MBot3D/MBot_3D_Printer_Board/GRID2+/INTERFACE.xls

BOM清单
产品型号：WHB-SYA
NO. | 名称 | 封装方式 | 规格 | 单位 | 数量 | 位号 | 品牌 | 备注
1 | 贴片电阻 | 0805 | 10K±1% | PCS | 7 | R3,R4,R5,R6,R7,R8,R9
2 | 贴片电容 | 0805 | 0.1UF±1% | PCS | 7 | C2,C3,C4,C5,C6,C7,C8
3 | IC | SOP-14 | 74AHC125D | PCS | 1 | IC1 | NXP
4 | SD卡槽 |  | SD二合一卡座 自弹式 11PIN | PCS | 1 | Q2 |  | 二合一卡座 自弹式
5 | 单排母 |  | 塑高6MM 1*20PIN |  | 1 | JP1 |  | 间距2.54MM 针数20 塑高6MM
6 |  |  | 塑高6MM 1*2PIN |  | 1 | JP3,JP4 |  | 间距2.54MM 针数2 塑高6MM
7 | 旋转编码器 |  | 旋转编码器（扁轴） 短柄 5脚 |  | 1 | S2 |  | 短柄15MM 带开关 定位数20位 额定电压5V 操作寿命30000次
8 | 接插件 |  | DC3牛角座弯角 26PIN |  | 1 | SV2 |  | 间距2.54MM 针数26PIN 弯角
单排母，旋转编码器，SD卡槽焊在同一面
2014.3.17
