MBot3D/MBot_3D_Printer_Board/GRID2+/MBot.xls

BOM清单
产品型号：MBot Cube Ⅱ
NO. | 名称 | 封装方式 | 规格 | 单位 | 数量 | 位号 | 品牌 | 备注
1 | 贴片电阻 | 805 | 0Ω | PCS | 11 | R5, R6, R8, R9, R11, R12, R14, R15,R17, R18, R67
 |  |  | 22Ω |  | 2 | R66,R69
 |  |  | 499Ω |  | 1 | R96
 |  |  | 1K±1% |  | 15 | R1, R68, R71, R72, R73, R74, R75, R76,R79,R81，R91, R103, R104, R105, R106, R107
 |  |  | 2.21K±1% |  | 10 | R4,R80,R87, R88, R97, R98, R99, R100, R101, R102
 |  |  | 4.7K±1% |  | 18 | R30,R39,R40,R41,R42,R43,R48,R53,R77,R78,R82, R83, R84, R85, R89,R90, R108, R109
 |  |  | 7.5K±1% |  | 5 | R34, R35, R36, R37, R38
 |  |  | 10K±1% |  | 13 | R7,R10,R13,R16,R19,R63,R64,R70,R86,R92,R93,R94,R95
 |  |  | 100K |  | 4 | R65,R110，R111，R112
 |  |  | 1M±1% |  | 3 | R113，R114，R115
2 | 贴片电容 | 805 | 22pF±5% | PCS | 5 | C15,C25,C26,C28,C29
 |  |  | 1uF±10% |  | 1 | C17
 |  |  | 10uF |  | 2 | C8,C9,
 |  |  | 100nF |  | 17 | C3,C4,C5,C6,C7,C16,C18,C19,C20,C21,C22,C23,C24,C27,C30, C32,C33
 |  | E型 | 47UF 35V 钽电容 |  | 5 | C10, C11, C12, C13, C14
3 | 直插电解电容 | E3,5-8 | 100uF/50V | PCS | 3 | C31,C34,C35
4 | IC |  | AQV252G 136 贴片 | PCS | 2 | U6,U7 | Panasonic
 |  |  | ATMEGA8U2-MU | PCS | 1 | U3 | Atmel
 |  |  | ATMEGA2560-16AU | PCS | 1 | U4 | Atmel
 |  | 805 | BLM21 磁珠 221 220R | PCS | 1 | L1 | TE
 |  | MSOP8 | NC7WZ02K8X | PCS | 1 | U5 | FAIRCHILD
 |  | SOP | PCA9533(PCA9533D)01,112 | PCS | 1 | U15 | NXP
 |  | 603 | PGB1010604 ESD静电保护PGB1010603(PGB1010603) | PCS | 2 | VR1，VR2 | Littelfuse
 |  | SOT89 | FDV301N | PCS | 3 | U16,17,U18 | FAIRCHILD
 |  |  | XC7WH14DC125 | PCS | 1 | U19 | NXP
 |  |  | PSMN7R0-30YL | PCS | 7 | Q1,Q2,Q3,Q4,Q5,Q6,Q7 | NXP
 |  |  | MCP4018T-502E/LT | PCS | 5 | U8,U9,U10,U11,U12 | Microchip
5 | 直插晶振 |  | 16MHZ 30ppm | PCS | 2 | Y1,Y2 | ABRACON | 相对偏差不高于30PPM
7 | 贴片二极管 | 805 | GREEN LED | PCS | 16 | 3.3V,5V,12V,DEBUG1, DEBUG2,DEBUG3,DEBUG4, FET1,FET2,FET3,FET4, FET5, FET6,FET7,RX,TX |  | 翠绿
 |  | 805 | RED LED | PCS | 1 | OVERHEAT |  | 红光
8 | 插件 |  | 8P单排母 2.54mm |  | 10 | BOTSTEP-A, BOTSTEP-B, BOTSTEP-X, BOTSTEP-Y, BOTSTEP-Z |  | 间距2.54MM 排母1*8PIN
 |  |  | CH3.96*4P |  | 5 | A-STEPPER, B-STEPPER, X-STEPPER, Y-STEPPER, Z-STEPPER |  | 间距3.96MM 针数4PIN
 |  |  | 70543-0003 4PIN 2.54MM |  | 7 | X-MAX,X-MIN,Y-MAX, Y-MIN,Z-MAX, Z-MIN,RGB-LED | MOLEX | 间距2.54MM 针数4PIN 黑色
 |  |  | 5569 20P弯角插座 |  | 1 | X3 |  | 间距4.2MM 针数20 弯针
 |  |  | 6P双排针2*3 (2mm的脚距) |  | 2 | ICSP1, ICSP2
 |  |  | USB-B型母座 D字型 |  | 1 | X2 |  | B型母座 D字型 直插
 |  |  | 接线端子 2P KF2EDGK 5.08MM 直针 （一套含插头插座） |  | 4 | TEPM1,TEMP2,CFAN1,CFAN2 |  | 间距5.08MM 针数2PIN 直针
 |  |  | 接线端子 4P KF2EDGK 5.08MM 直针 （一套含插头插座） |  | 2 | EX1,EX2 |  | 间距5.08MM 针数4PIN 直针
 |  |  | 轻触按钮开关6*6*5 4脚 B3F-1022 |  | 1 | S1 | Omron | 尺寸 6*6*5 4脚1.47N
 |  |  | DC蜂鸣器 压电式 14*7 6-24V |  | 1 | LS1 |  | 压电式 额定电压12V 型号HYD1407B
 |  |  | DC3-26P |  | 1 | INTERFACE |  | 间距2.54MM 针数26PIN
2014.3.17
