MBot3D/MBot_3D_Printer_Board/MINI/INTERFACE.xls

BOM清单
产品型号：WHB-SYA
NO. | 名称 | 封装方式 | 规格 | 单位 | 数量 | 位号 | 品牌 | 备注
1 | 贴片电阻 | 805 | 10K±1% | PCS | 7 | R3,R4,R5,R6,R7,R8,R9
2 | 贴片电容 | 805 | 0.1UF±1% | PCS | 7 | C2,C3,C4,C5,C6,C7,C8
3 | 直插电解电容 | E3,5-8 | 220uF/35V | PCS | 1 | C10
4 |  | E3,5-8 | 220uF/25V | PCS | 1 | C11
5 | IC | SOP-14 | 74AHC125D | PCS | 1 | IC1 | NXP
6 |  | TO263-5 | LM2596S-3.3V | PCS | 1 | Q1 | Texas Instruments
7 | SD卡座 |  | SD二合一卡座 自弹式 11PIN | PCS | 1 | Q2 | SD二合一卡座 自弹式
8 | 排座 |  | 塑高6MM 20PIN |  | 1 | JP1 | 间距2.54MM 针数20 塑高6MM
9 |  |  | 塑高6MM 2PIN |  | 1 | JP3,JP4 | 间距2.54MM 针数2 塑高6MM
10 | 贴片电感 | 12*12*7 | 12*12*7 33uH | PCS | 1 | L1 | 标字330 感量33UH | 标字330 感量33UH
11 | 肖特基二极管 | SMA | SS34 | PCS | 1 | D1 | Fairchild Semiconductor | IN5822 SS34 SMA
12 | 旋转编码器 |  | 旋转编码器（扁轴） 短柄 5脚 |  | 1 | S2 | 短柄15MM 带开关 定位数20位 额定电压5V 操作寿命30000次
13 | 接插件 |  | DC3-26P |  | 1 | SV1 | 间距2.54MM 针数26PIN
SD卡座，单排母和旋转编码器焊在同一面
2014.3.17
