MBot3D/MBot_3D_Printer_Board/GRID2+/INTERFACE.brd

## EAGLE design GRID2+/INTERFACE.brd (2015-03-09)

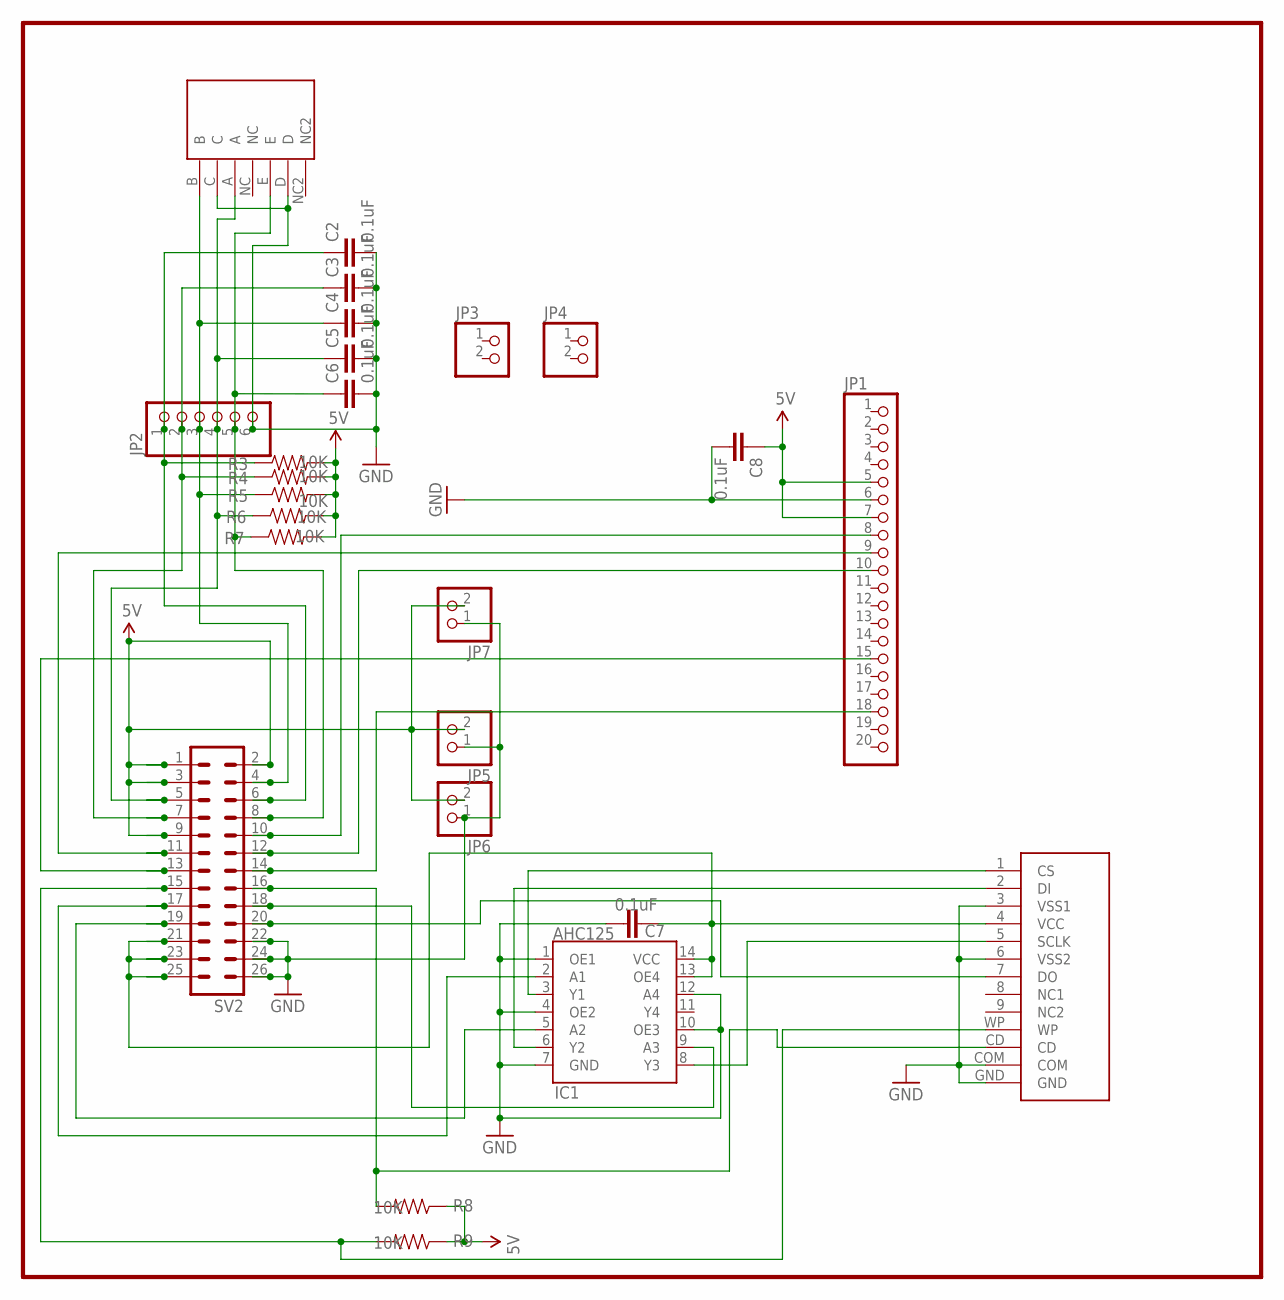
[picture p1: schematic INTERFACE.sch]

Parts:
C2, C3, C4, C5, C6, C7, C8: 0.1uF; 0805
IC1: AHC125; DIN14
JP1: PINHD-1X20; 1X20
JP2: PINHD-1X6; 1X06
JP3, JP4, JP5, JP6, JP7: PINHD-1X2; 1X02
Q2: SDCARD
R3, R4, R5, R6, R7, R8, R9: 10K; 0805
S2: DJFS; PIN5
SV2: ML26L

Connections:
5V: C8.1, JP1.5, JP1.7, JP5.2, JP6.2, JP7.2, R3.2, R4.2, R5.2, R6.2, R7.2, R8.1, R9.1, SV2.1, SV2.2, SV2.3, SV2.9
GND2: C2.2, C3.2, C4.2, C5.2, C6.2, C7.2, C8.2, IC1.1 (OE1), IC1.4 (OE2), IC1.7 (GND), IC1.10 (OE3), IC1.12 (A4), JP1.6, JP2.6, JP5.1, JP6.1, JP7.1, Q2.3 (VSS1), Q2.6 (VSS2), Q2.COM, Q2.GND, S2.C, S2.D, SV2.22, SV2.24, SV2.26
unnamed: IC1.3 (Y1), Q2.1 (CS)
unnamed: C2.1, JP2.1, R3.1, SV2.6
unnamed: IC1.2 (A1), SV2.17
unnamed: IC1.6 (Y2), Q2.2 (DI)
unnamed: Q2.CD, R8.2, SV2.16
unnamed: Q2.7 (DO), SV2.20
unnamed: JP1.15, SV2.13
unnamed: JP1.8, SV2.10
unnamed: JP1.10, SV2.12
unnamed: JP1.9, SV2.11
unnamed: JP1.18, SV2.14
unnamed: IC1.8 (Y3), Q2.5 (SCLK)
unnamed: C3.1, JP2.2, R4.1, SV2.7
unnamed: C4.1, JP2.3, R5.1, S2.B, SV2.4
unnamed: C5.1, JP2.4, R6.1, S2.A, SV2.5
unnamed: C6.1, JP2.5, R7.1, S2.E, SV2.8
unnamed: Q2.WP, R9.2, SV2.15
unnamed: IC1.5 (A2), SV2.19
unnamed: C7.1, IC1.13 (OE4), IC1.14 (VCC), Q2.4 (VCC), SV2.21, SV2.23, SV2.25
unnamed: IC1.9 (A3), SV2.18

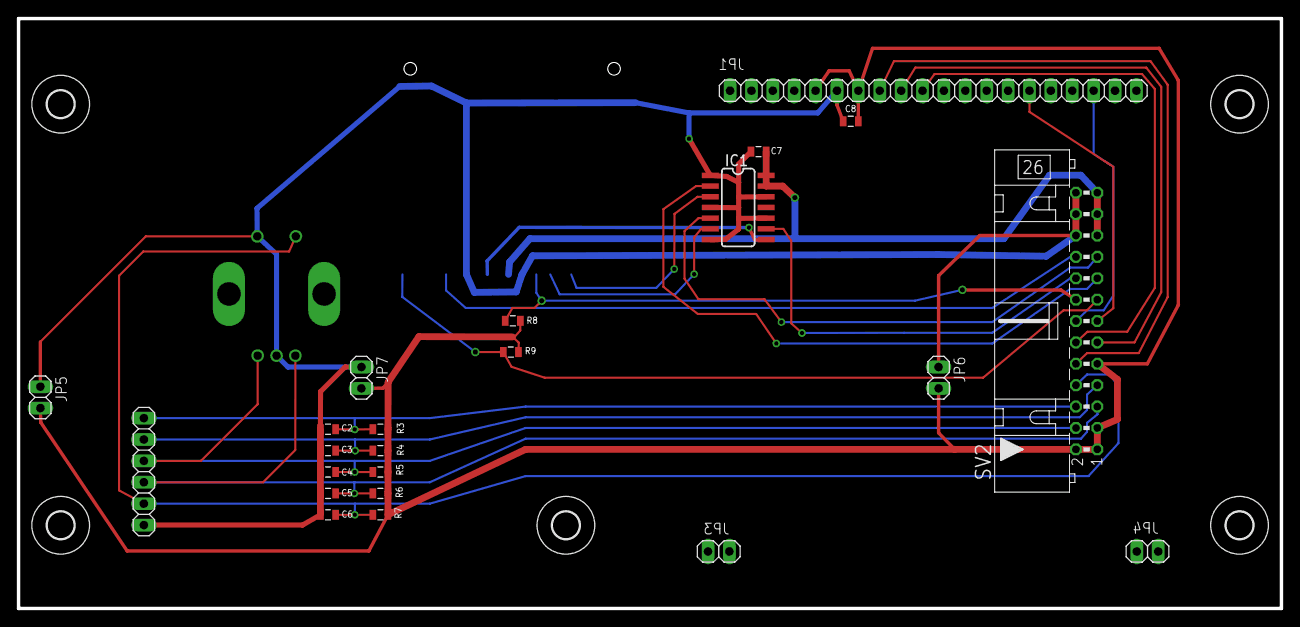
[picture p2: board GRID2+/INTERFACE.brd from above]

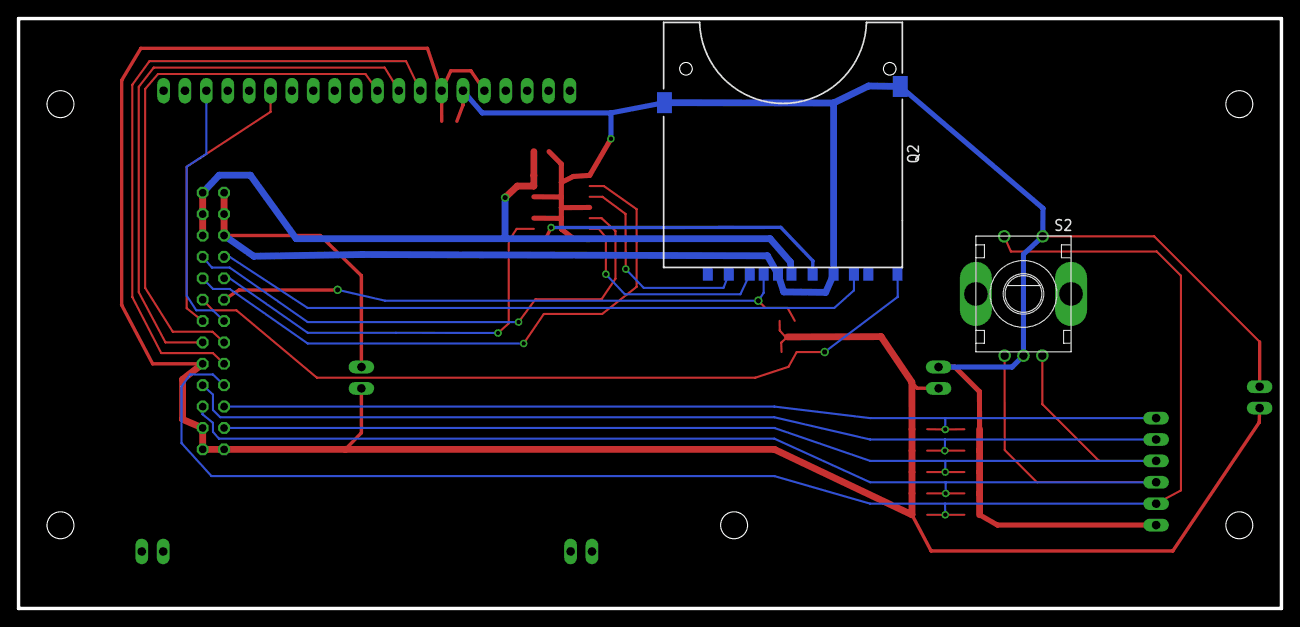
[picture p3: board GRID2+/INTERFACE.brd from below]

Board: 2 copper layers, 150.0 x 70.1 mm, 30 parts (2 on the bottom side), 22 nets.

Other parts of the board:
U$3, U$5, U$11, U$12, U$13: 3,2
