MBot3D/MBot_3D_Printer_Board/GRID2+/MBot.brd

## EAGLE design GRID2+/MBot.brd (2015-03-09)

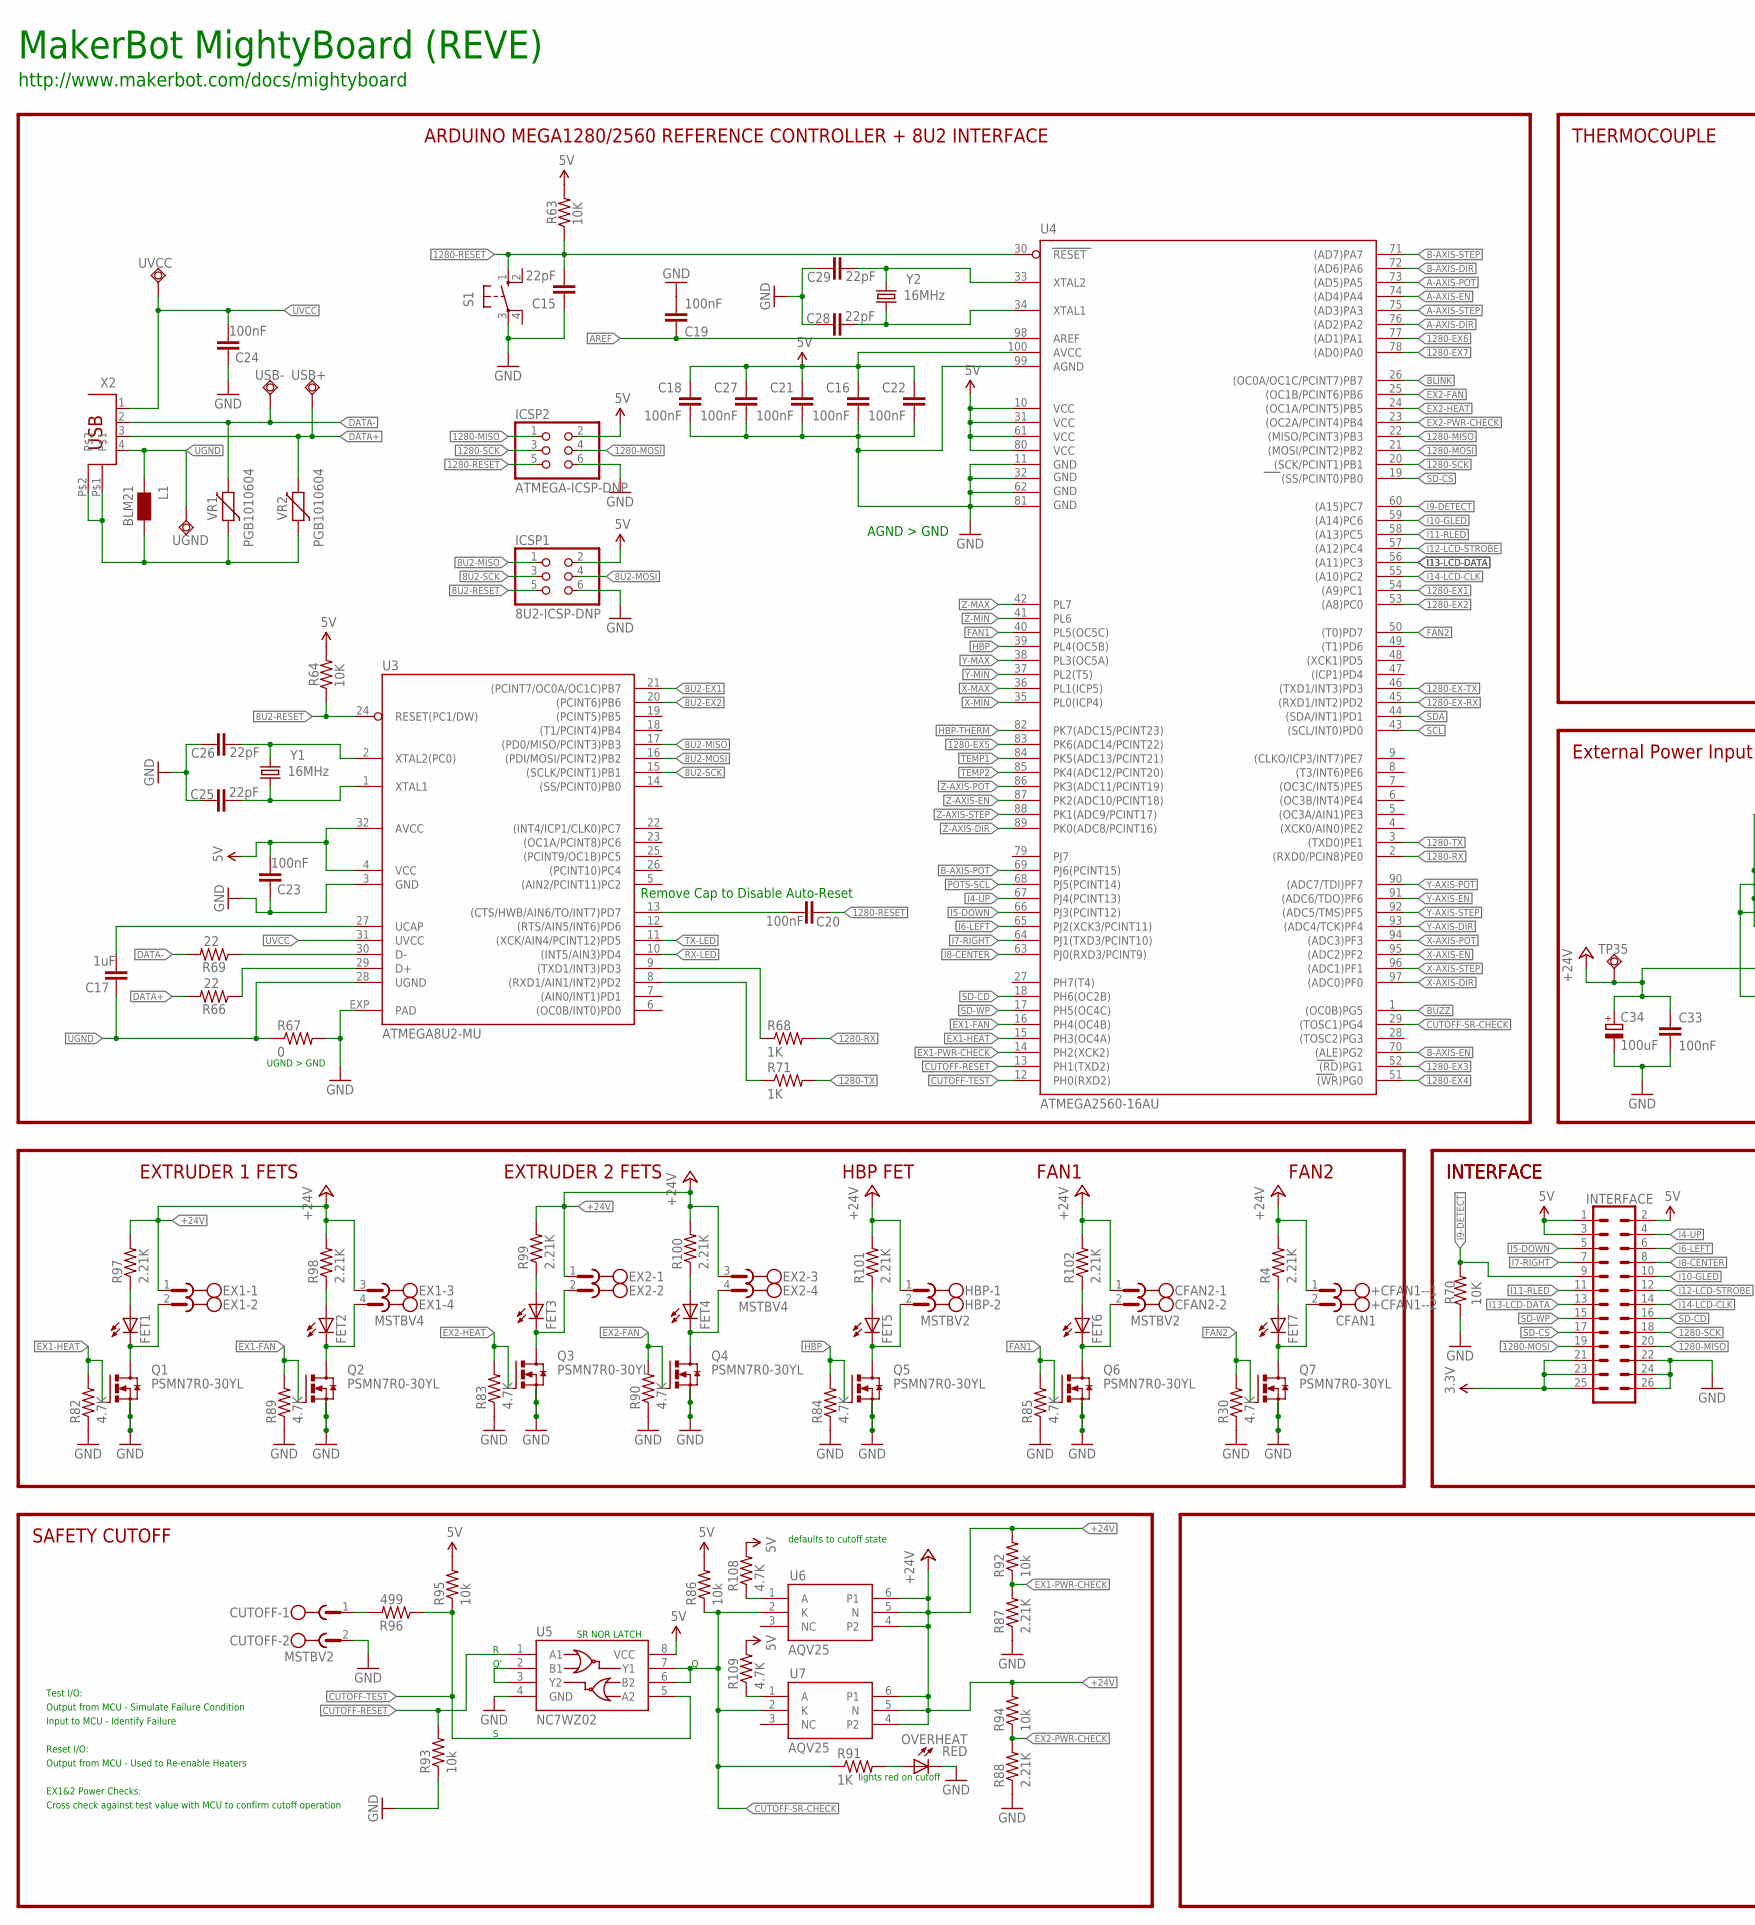
[picture p4: schematic MBot.sch, part in row 1, column 1]

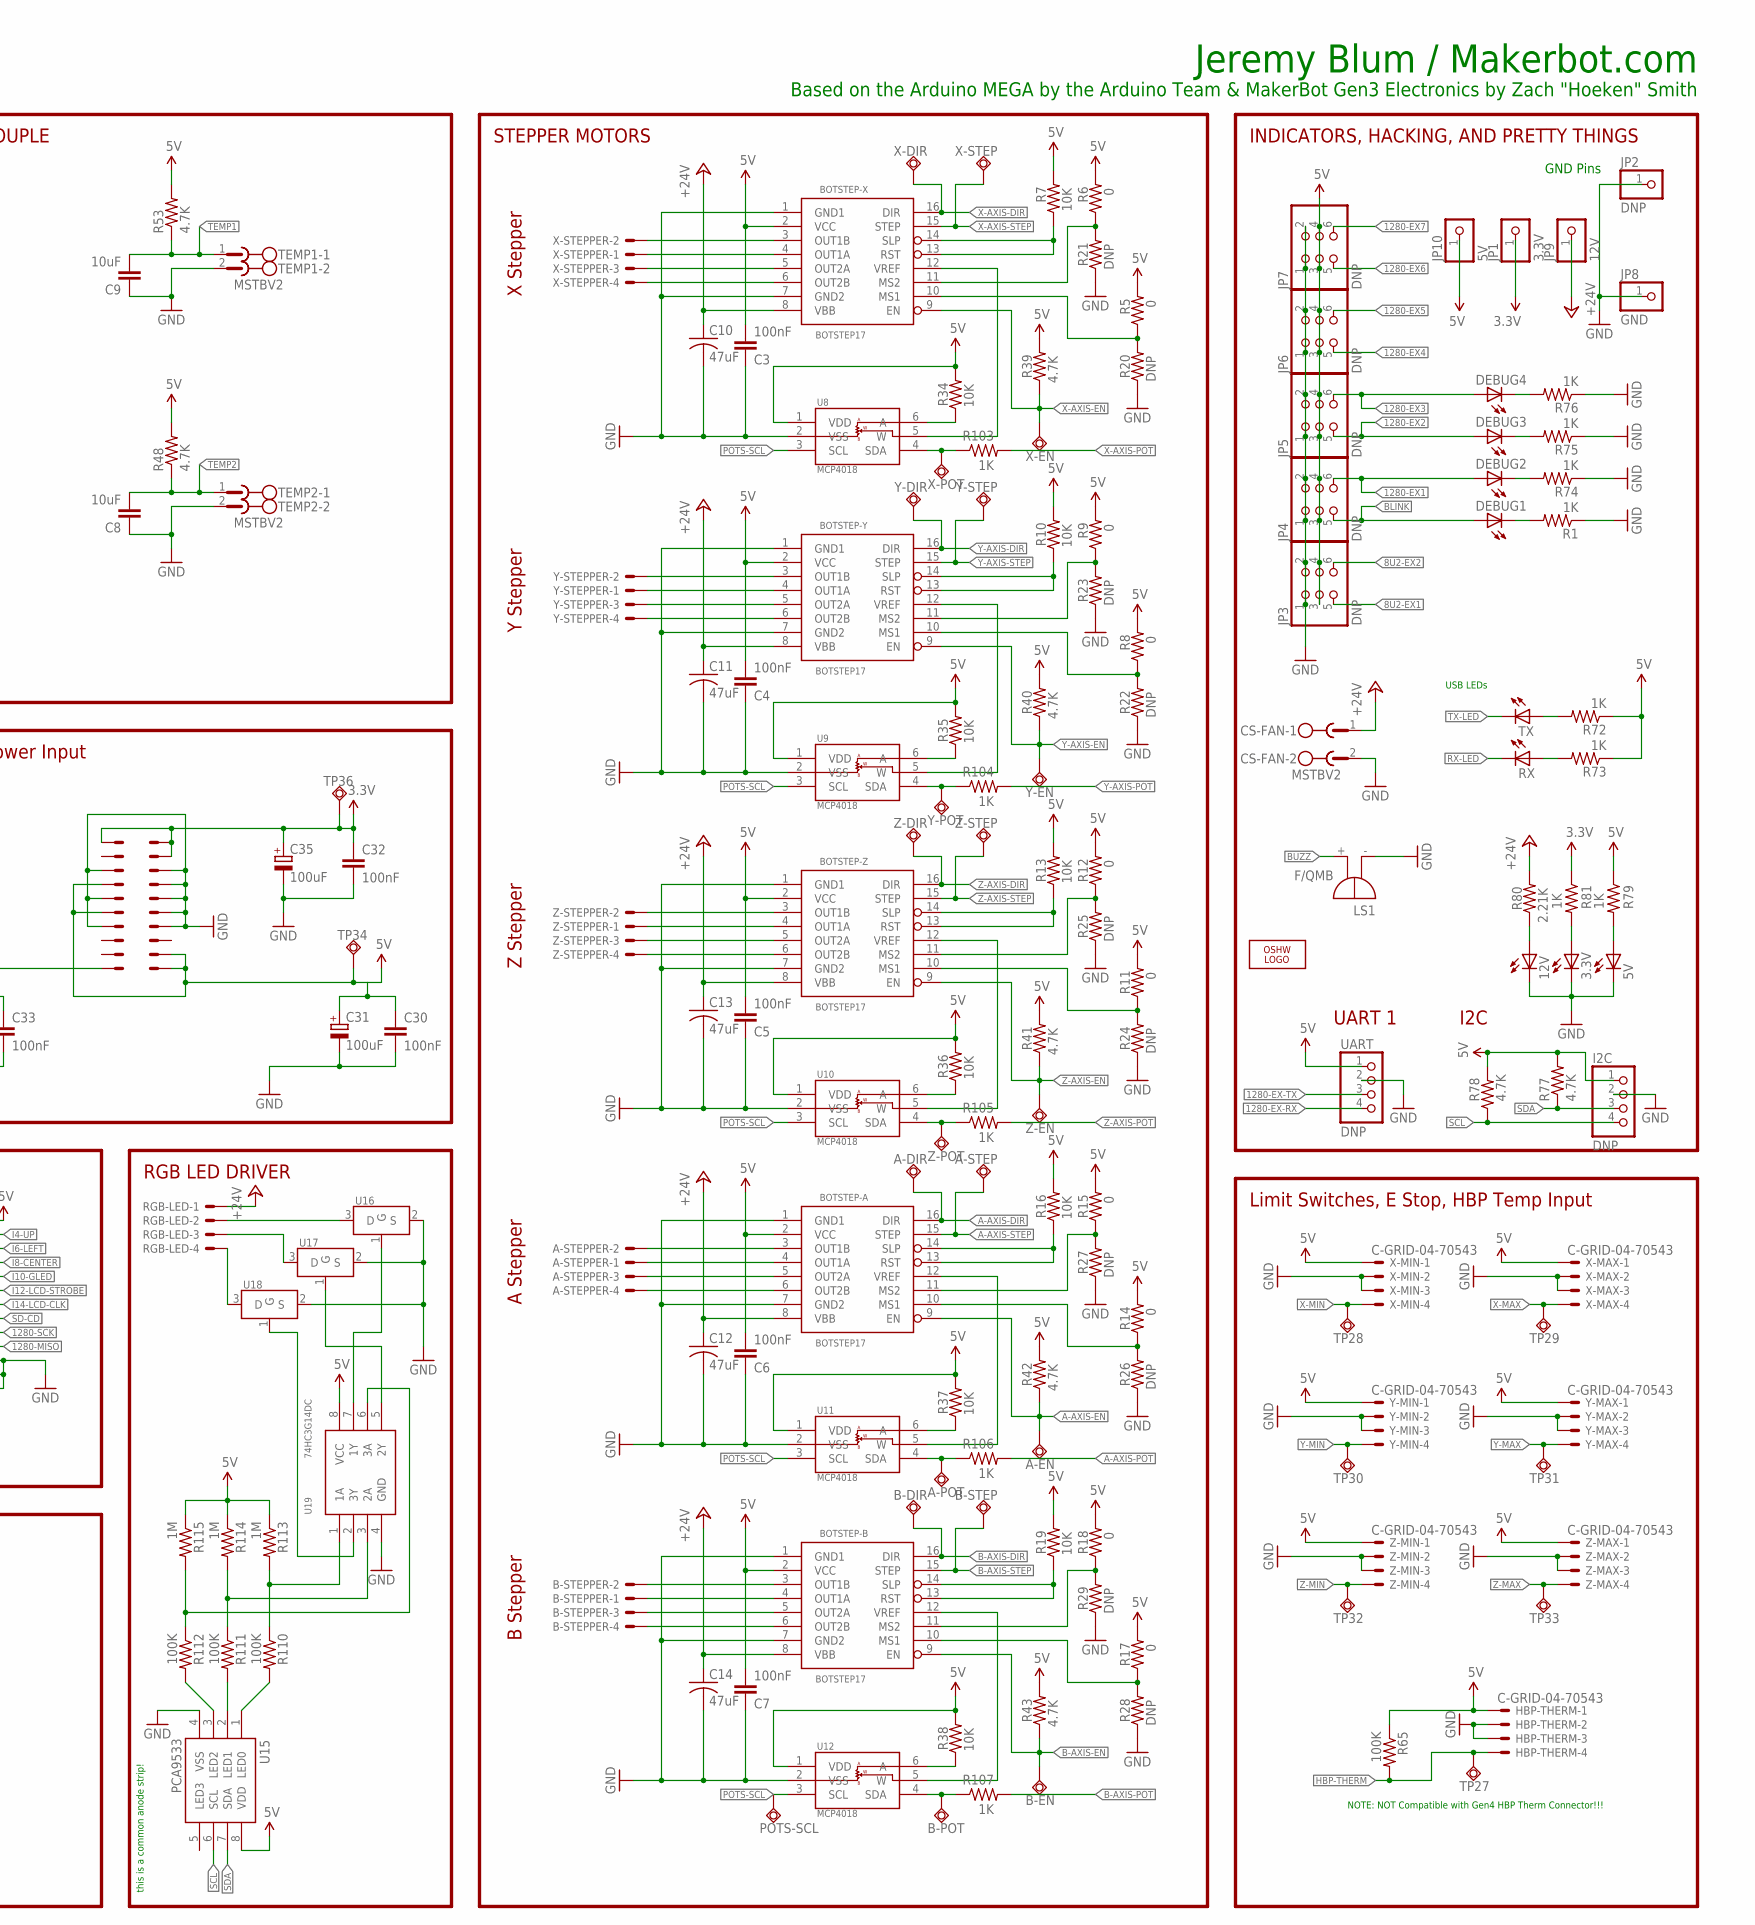
[picture p5: schematic MBot.sch, part in row 1, column 2]

Parts:
3.3V, 5V, 12V: GREEN; LED-0805
+CFAN1-: CFAN1; MSTBV2
A-DIR: TPSQTP09R; TP09R
A-EN: TPSQTP09R; TP09R
A-POT: TPSQTP09R; TP09R
A-STEP: TPSQTP09R; TP09R
A-STEPPER: KK-156-4
B-DIR: TPSQTP09R; TP09R
B-EN: TPSQTP09R; TP09R
B-POT: TPSQTP09R; TP09R
B-STEP: TPSQTP09R; TP09R
B-STEPPER: KK-156-4
BOTSTEP-A: BOTSTEP17; BOTSTEP17-INV
BOTSTEP-B: BOTSTEP17; BOTSTEP17-INV
BOTSTEP-X: BOTSTEP17; BOTSTEP17-INV
BOTSTEP-Y: BOTSTEP17; BOTSTEP17-INV
BOTSTEP-Z: BOTSTEP17; BOTSTEP17-INV
C3, C4, C5, C6, C7, C16, C18, C19, C20, C21, C22, C23, C24, C27, C30, C32, C33: 100nF; 0805
C8, C9: 10uF; 0805
C10, C11, C12, C13, C14: 47uF; CAP2917
C15, C25, C26, C28, C29: 22pF; 0805
C17: 1uF; 0805
C31, C34, C35: 100uF; E3,5-8
CFAN2: MSTBV2
CS-FAN: MSTBV2
CUTOFF: MSTBV2
DEBUG1, DEBUG2, DEBUG3, DEBUG4: GREEN; LED-0805
EX1, EX2: MSTBV4
FET1, FET2, FET3, FET4, FET5, FET6, FET7: GREEN; LED-0805
HBP: MSTBV2
HBP-THERM: C-GRID-04-70543; 70543-04
I2C: DNP; 1X04
ICSP1: 8U2-ICSP-DNP; 2X03
ICSP2: ATMEGA-ICSP-DNP; 2X03
INTERFACE: ML26
JP1: 3.3V; 1X01
JP2: DNP; 1X01
JP3, JP4, JP5, JP6, JP7: DNP; 2X03
JP8: GND; 1X01
JP9: 12V; 1X01
JP10: 5V; 1X01
L1: BLM21; 0805
LOGO2: OSHW_LOGO_10MILX0200-NT; OSHW_10X200_NOTEXT
LS1: F/QMB
OVERHEAT: RED; LED-0805
POTS-SCL: TPSQTP09R; TP09R
Q1, Q2, Q3, Q4, Q5, Q6, Q7: PSMN7R0-30YL; SOT669
R1, R68, R71, R72, R73, R74, R75, R76, R79, R81, R91, R103, R104, R105, R106, R107: 1K; 0805
R4, R80, R87, R88, R97, R98, R99, R100, R101, R102: 2.21K; 0805
R5, R6, R8, R9, R11, R12, R14, R15, R17, R18, R67: 0; 0805
R7, R10, R13, R16, R19, R34, R35, R36, R37, R38, R63, R64, R70: 10K; 0805
R20, R21, R22, R23, R24, R25, R26, R27, R28, R29: DNP; 0805
R30, R39, R40, R41, R42, R43, R48, R53, R77, R78, R82, R83, R84, R85, R89, R90, R108, R109: 4.7K; 0805
R65, R110, R111, R112: 100K; 0805
R66, R69: 22; 0805
R86, R92, R93, R94, R95: 10k; 0805
R96: 499; 0805
R113, R114, R115: 1M; 0805
RGB-LED: C-GRID-04-70543; 70543-04
RX: GREEN; LED-0805
S1: 10-XX; B3F-10XX
TEMP1, TEMP2: MSTBV2; MPN MSTBV 2,5/2-GF-5.08
TP27, TP28, TP29, TP30, TP31, TP32, TP33, TP34, TP35, TP36: TPSQTP09R; TP09R
TX: GREEN; LED-0805
U3: ATMEGA8U2-MU; QFN32
U4: ATMEGA2560-16AU; TQFP100
U5: NC7WZ02; US8
U6, U7: AQV25; AQV25-DIPSM
U8, U9, U10, U11, U12: MCP4018; SC70-6L
U15: PCA9533; SO8
U16, U17, U18: FDV301N; SOT-23
U19: 74HC3G14DC; VSSOP8
UART: DNP; 1X04
UGND: TPSQTP09R; TP09R
USB+: TPSQTP09R; TP09R
USB-: TPSQTP09R; TP09R
UVCC: TPSQTP09R; TP09R
VR1, VR2: PGB1010604; CT/CN0603
X2: USBA; SMARTPRJ_PN61729
X3: 5569
X-DIR: TPSQTP09R; TP09R
X-EN: TPSQTP09R; TP09R
X-MAX: C-GRID-04-70543; 70543-04
X-MIN: C-GRID-04-70543; 70543-04
X-POT: TPSQTP09R; TP09R
X-STEP: TPSQTP09R; TP09R
X-STEPPER: KK-156-4
Y1, Y2: 16MHz; HC49/S
Y-DIR: TPSQTP09R; TP09R
Y-EN: TPSQTP09R; TP09R
Y-MAX: C-GRID-04-70543; 70543-04
Y-MIN: C-GRID-04-70543; 70543-04
Y-POT: TPSQTP09R; TP09R
Y-STEP: TPSQTP09R; TP09R
Y-STEPPER: KK-156-4
Z-DIR: TPSQTP09R; TP09R
Z-EN: TPSQTP09R; TP09R
Z-MAX: C-GRID-04-70543; 70543-04
Z-MIN: C-GRID-04-70543; 70543-04
Z-POT: TPSQTP09R; TP09R
Z-STEP: TPSQTP09R; TP09R
Z-STEPPER: KK-156-4

Connections:
3.3V: C32.1, C35.+, INTERFACE.21, INTERFACE.23, INTERFACE.25, JP1.1, R81.1, TP36.TP, X3.1, X3.2, X3.4
5V: BOTSTEP-A.2 (VCC), BOTSTEP-B.2 (VCC), BOTSTEP-X.2 (VCC), BOTSTEP-Y.2 (VCC), BOTSTEP-Z.2 (VCC), C3.2, C4.2, C5.2, C6.2, C7.2, C16.1, C18.1, C21.1, C22.1, C23.2, C27.1, C30.1, C31.+, HBP-THERM.1, I2C.1, ICSP1.2, ICSP2.2, INTERFACE.1, INTERFACE.2, INTERFACE.3, JP3.3, JP3.4, JP4.3, JP4.4, JP5.3, JP5.4, JP6.3, JP6.4, JP7.3, JP7.4, JP10.1, R5.2, R6.2, R7.2, R8.2, R9.2, R10.2, R11.2, R12.2, R13.2, R14.2, R15.2, R16.2, R17.2, R18.2, R19.2, R34.2, R35.2, R36.2, R37.2, R38.2, R39.2, R40.2, R41.2, R42.2, R43.2, R48.2, R53.2, R63.2, R64.2, R65.1, R72.1, R73.1, R77.2, R78.2, R79.1, R86.2, R95.2, R108.2, R109.2, R113.1, R114.1, R115.1, TP34.TP, U3.4 (VCC), U3.32 (AVCC), U4.10 (VCC), U4.31 (VCC1), U4.61 (VCC2), U4.80 (VCC3), U4.100 (AVCC), U5.8 (VCC), U8.1 (VDD), U9.1 (VDD), U10.1 (VDD), U11.1 (VDD), U12.1 (VDD), U15.8 (VDD), U19.8 (VCC), UART.1, X3.7, X3.11, X3.18, X3.20, X-MAX.1, X-MIN.1, Y-MAX.1, Y-MIN.1, Z-MAX.1, Z-MIN.1
8U2-EX1: JP3.5, U3.21 ((PCINT7/OC0A/OC1C)PB7)
8U2-EX2: JP3.6, U3.20 ((PCINT6)PB6)
8U2-MISO: ICSP1.1, U3.17 ((PD0/MISO/PCINT3)PB3)
8U2-MOSI: ICSP1.4, U3.16 ((PDI/MOSI/PCINT2)PB2)
8U2-RESET: ICSP1.5, R64.1, U3.24 (RESET(PC1/DW))
8U2-SCK: ICSP1.3, U3.15 ((SCLK/PCINT1)PB1)
1280-EX1: DEBUG2.A, JP4.6, U4.54 ((A9)PC1)
1280-EX2: DEBUG3.A, JP5.5, U4.53 ((A8)PC0)
1280-EX3: DEBUG4.A, JP5.6, U4.52 ((RD)PG1)
1280-EX4: JP6.5, U4.51 ((WR)PG0)
1280-EX5: JP6.6, U4.83 (PK6(ADC14/PCINT22))
1280-EX6: JP7.5, U4.77 ((AD1)PA1)
1280-EX7: JP7.6, U4.78 ((AD0)PA0)
1280-EX-RX: U4.45 ((RXD1/INT2)PD2), UART.4
1280-EX-TX: U4.46 ((TXD1/INT3)PD3), UART.3
1280-MISO: ICSP2.1, INTERFACE.20, U4.22 ((MISO/PCINT3)PB3)
1280-MOSI: ICSP2.4, INTERFACE.19, U4.21 ((MOSI/PCINT2)PB2)
1280-RESET: C15.2, C20.1, ICSP2.5, R63.1, S1.1 (S), U4.30 (RESET)
1280-RX: R68.2, U4.2 ((RXD0/PCIN8)PE0)
1280-SCK: ICSP2.3, INTERFACE.18, U4.20 ((SCK/PCINT1)PB1)
1280-TX: R71.2, U4.3 ((TXD0)PE1)
+24V: +CFAN1-.1, BOTSTEP-A.8 (VBB), BOTSTEP-B.8 (VBB), BOTSTEP-X.8 (VBB), BOTSTEP-Y.8 (VBB), BOTSTEP-Z.8 (VBB), C10.1, C11.1, C12.1, C13.1, C14.1, C33.1, C34.+, CFAN2.1, CS-FAN.1, EX1.1, EX1.3, EX2.1, EX2.3, HBP.1, JP9.1, R4.2, R80.2, R92.2, R94.2, R97.2, R98.2, R99.2, R100.2, R101.2, R102.2, RGB-LED.1, TP35.TP, U6.4 (P2), U6.5 (N), U6.6 (P1), U7.4 (P2), U7.5 (N), U7.6 (P1), X3.19
A-AXIS-DIR: A-DIR.TP, BOTSTEP-A.16 (DIR), U4.76 ((AD2)PA2)
A-AXIS-EN: A-EN.TP, BOTSTEP-A.9 (EN), R42.1, U4.74 ((AD4)PA4)
A-AXIS-POT: R106.2, U4.73 ((AD5)PA5)
A-AXIS-STEP: A-STEP.TP, BOTSTEP-A.15 (STEP), U4.75 ((AD3)PA3)
APWR1: EX1.4, FET2.C, Q2.MB (D)
AREF: C19.1, U4.98 (AREF)
B-AXIS-DIR: B-DIR.TP, BOTSTEP-B.16 (DIR), U4.72 ((AD6)PA6)
B-AXIS-EN: B-EN.TP, BOTSTEP-B.9 (EN), R43.1, U4.70 ((ALE)PG2)
B-AXIS-POT: R107.2, U4.69 (PJ6(PCINT15))
B-AXIS-STEP: B-STEP.TP, BOTSTEP-B.15 (STEP), U4.71 ((AD7)PA7)
BLINK: DEBUG1.A, JP4.5, U4.26 ((OC0A/OC1C/PCINT7)PB7)
BPWR: EX2.2, FET3.C, Q3.MB (D)
BPWR1: EX2.4, FET4.C, Q4.MB (D)
BUZZ: LS1.+ (-), U4.1 ((OC0B)PG5)
CPWR: FET5.C, HBP.2, Q5.MB (D)
CUTOFF-RESET: R93.2, U4.13 (PH1(TXD2)), U5.1 (A1)
CUTOFF-SR-CHECK: R86.1, R91.1, U4.29 ((TOSC1)PG4), U5.6 (B2), U5.7 (Y1), U6.2 (K), U7.2 (K)
CUTOFF-TEST: R95.1, R96.1, U4.12 (PH0(RXD2)), U5.5 (A2)
DATA+: R66.2, USB+.TP, VR2.2, X2.3
DATA-: R69.2, USB-.TP, VR1.2, X2.2
DPWR: CFAN2.2, FET6.C, Q6.MB (D)
DPWR1: +CFAN1-.2, FET7.C, Q7.MB (D)
DTR: C20.2, U3.13 ((CTS/HWB/AIN6/TO/INT7)PD7)
EX1-FAN: Q2.4 (G), R89.2, U4.16 (PH4(OC4B))
EX1-HEAT: Q1.4 (G), R82.2, U4.15 (PH3(OC4A))
EX1-PWR-CHECK: R87.2, R92.1, U4.14 (PH2(XCK2))
EX2-FAN: Q4.4 (G), R90.2, U4.25 ((OC1B/PCINT6)PB6)
EX2-HEAT: Q3.4 (G), R83.2, U4.24 ((OC1A/PCINT5)PB5)
EX2-PWR-CHECK: R88.2, R94.1, U4.23 ((OC2A/PCINT4)PB4)
FAN1: Q6.4 (G), R85.2, U4.40 (PL5(OC5C))
FAN2: Q7.4 (G), R30.2, U4.50 ((T0)PD7)
GND: 3.3V.C, 5V.C, 12V.C, BOTSTEP-A.1 (GND1), BOTSTEP-A.7 (GND2), BOTSTEP-B.1 (GND1), BOTSTEP-B.7 (GND2), BOTSTEP-X.1 (GND1), BOTSTEP-X.7 (GND2), BOTSTEP-Y.1 (GND1), BOTSTEP-Y.7 (GND2), BOTSTEP-Z.1 (GND1), BOTSTEP-Z.7 (GND2), C3.1, C4.1, C5.1, C6.1, C7.1, C8.1, C9.1, C10.2, C11.2, C12.2, C13.2, C14.2, C15.1, C16.2, C18.2, C19.2, C21.2, C22.2, C23.1, C24.1, C25.1, C26.1, C27.2, C28.1, C29.1, C30.2, C31.-, C32.2, C33.2, C34.-, C35.-, CS-FAN.2, CUTOFF.2, HBP-THERM.2, HBP-THERM.3, I2C.2, ICSP1.6, ICSP2.6, INTERFACE.22, INTERFACE.24, INTERFACE.26, JP2.1, JP3.1, JP3.2, JP4.1, JP4.2, JP5.1, JP5.2, JP6.1, JP6.2, JP7.1, JP7.2, JP8.1, LS1.- (+), OVERHEAT.C, Q1.1 (S), Q1.2 (S), Q1.3 (S), Q2.1 (S), Q2.2 (S), Q2.3 (S), Q3.1 (S), Q3.2 (S), Q3.3 (S), Q4.1 (S), Q4.2 (S), Q4.3 (S), Q5.1 (S), Q5.2 (S), Q5.3 (S), Q6.1 (S), Q6.2 (S), Q6.3 (S), Q7.1 (S), Q7.2 (S), Q7.3 (S), R1.1, R20.1, R21.1, R22.1, R23.1, R24.1, R25.1, R26.1, R27.1, R28.1, R29.1, R30.1, R67.2, R70.1, R74.1, R75.1, R76.1, R82.1, R83.1, R84.1, R85.1, R87.1, R88.1, R89.1, R90.1, R93.1, S1.3, TEMP1.2, TEMP2.2, U3.3 (GND), U3.EXP (PAD), U4.11 (GND), U4.32 (GND1), U4.62 (GND2), U4.81 (GND3), U4.99 (AGND), U5.4 (GND), U8.2 (VSS), U9.2 (VSS), U10.2 (VSS), U11.2 (VSS), U12.2 (VSS), U15.4 (VSS), U16.2 (S), U17.2 (S), U18.2 (S), U19.4 (GND), UART.2, X3.5, X3.6, X3.8, X3.9, X3.10, X3.12, X3.13, X3.14, X-MAX.2, X-MAX.3, X-MIN.2, X-MIN.3, Y-MAX.2, Y-MAX.3, Y-MIN.2, Y-MIN.3, Z-MAX.2, Z-MAX.3, Z-MIN.2, Z-MIN.3
HBP: Q5.4 (G), R84.2, U4.39 (PL4(OC5B))
HBP-THERM: HBP-THERM.4, R65.2, TP27.TP, U4.82 (PK7(ADC15/PCINT23))
I4-UP: INTERFACE.4, U4.67 (PJ4(PCINT13))
I5-DOWN: INTERFACE.5, U4.66 (PJ3(PCINT12))
I6-LEFT: INTERFACE.6, U4.65 (PJ2(XCK3/PCINT11))
I7-RIGHT: INTERFACE.7, U4.64 (PJ1(TXD3/PCINT10))
I8-CENTER: INTERFACE.8, U4.63 (PJ0(RXD3/PCINT9))
I9-DETECT: INTERFACE.9, R70.2, U4.60 ((A15)PC7)
I10-GLED: INTERFACE.10, U4.59 ((A14)PC6)
I11-RLED: INTERFACE.11, U4.58 ((A13)PC5)
I12-LCD-STROBE: INTERFACE.12, U4.57 ((A12)PC4)
I13-LCD-DATA: INTERFACE.13, U4.56 ((A11)PC3)
I14-LCD-CLK: INTERFACE.14, U4.55 ((A10)PC2)
M8RXD: R68.1, U3.9 ((TXD1/INT3)PD3)
M8TXD: R71.1, U3.8 ((RXD1/AIN1/INT2)PD2)
unnamed: 3.3V.A, R81.2
unnamed: C28.2, U4.34 (XTAL1), Y2.1
unnamed: 5V.A, R79.2
unnamed: DEBUG4.C, R76.2
unnamed: DEBUG1.C, R1.2
unnamed: FET2.A, R98.1
unnamed: FET4.A, R100.1
unnamed: 12V.A, R80.1
unnamed: FET6.A, R102.1
unnamed: C29.2, U4.33 (XTAL2), Y2.2
unnamed: DEBUG2.C, R74.2
unnamed: DEBUG3.C, R75.2
unnamed: FET5.A, R101.1
unnamed: BOTSTEP-X.10 (MS1), R5.1, R20.2
unnamed: FET7.A, R4.1
unnamed: CUTOFF.1, R96.2
unnamed: BOTSTEP-X.13 (RST), BOTSTEP-X.14 (SLP), R7.1
unnamed: FET1.A, R97.1
unnamed: FET3.A, R99.1
unnamed: BOTSTEP-X.12 (VREF), U8.5 (W)
unnamed: R34.1, U8.6 (A)
unnamed: BOTSTEP-X.11 (MS2), R6.1, R21.2
unnamed: BOTSTEP-Y.13 (RST), BOTSTEP-Y.14 (SLP), R10.1
unnamed: BOTSTEP-X.3 (OUT1B), X-STEPPER.2
unnamed: BOTSTEP-X.4 (OUT1A), X-STEPPER.1
unnamed: BOTSTEP-X.5 (OUT2A), X-STEPPER.3
unnamed: BOTSTEP-X.6 (OUT2B), X-STEPPER.4
unnamed: OVERHEAT.A, R91.2
unnamed: BOTSTEP-Y.12 (VREF), U9.5 (W)
unnamed: R35.1, U9.6 (A)
unnamed: BOTSTEP-Y.11 (MS2), R9.1, R23.2
unnamed: BOTSTEP-Y.3 (OUT1B), Y-STEPPER.2
unnamed: BOTSTEP-Y.4 (OUT1A), Y-STEPPER.1
unnamed: BOTSTEP-Y.5 (OUT2A), Y-STEPPER.3
unnamed: BOTSTEP-Y.6 (OUT2B), Y-STEPPER.4
unnamed: BOTSTEP-Y.10 (MS1), R8.1, R22.2
unnamed: BOTSTEP-Z.13 (RST), BOTSTEP-Z.14 (SLP), R13.1
unnamed: BOTSTEP-Z.12 (VREF), U10.5 (W)
unnamed: R36.1, U10.6 (A)
unnamed: BOTSTEP-Z.11 (MS2), R12.1, R25.2
unnamed: BOTSTEP-Z.3 (OUT1B), Z-STEPPER.2
unnamed: BOTSTEP-Z.4 (OUT1A), Z-STEPPER.1
unnamed: BOTSTEP-Z.5 (OUT2A), Z-STEPPER.3
unnamed: BOTSTEP-Z.6 (OUT2B), Z-STEPPER.4
unnamed: BOTSTEP-Z.10 (MS1), R11.1, R24.2
unnamed: BOTSTEP-A.13 (RST), BOTSTEP-A.14 (SLP), R16.1
unnamed: BOTSTEP-A.12 (VREF), U11.5 (W)
unnamed: R37.1, U11.6 (A)
unnamed: BOTSTEP-A.11 (MS2), R15.1, R27.2
unnamed: A-STEPPER.2, BOTSTEP-A.3 (OUT1B)
unnamed: A-STEPPER.1, BOTSTEP-A.4 (OUT1A)
unnamed: A-STEPPER.3, BOTSTEP-A.5 (OUT2A)
unnamed: A-STEPPER.4, BOTSTEP-A.6 (OUT2B)
unnamed: BOTSTEP-A.10 (MS1), R14.1, R26.2
unnamed: BOTSTEP-B.13 (RST), BOTSTEP-B.14 (SLP), R19.1
unnamed: BOTSTEP-B.12 (VREF), U12.5 (W)
unnamed: R38.1, U12.6 (A)
unnamed: BOTSTEP-B.11 (MS2), R18.1, R29.2
unnamed: B-STEPPER.2, BOTSTEP-B.3 (OUT1B)
unnamed: B-STEPPER.1, BOTSTEP-B.4 (OUT1A)
unnamed: B-STEPPER.3, BOTSTEP-B.5 (OUT2A)
unnamed: B-STEPPER.4, BOTSTEP-B.6 (OUT2B)
unnamed: BOTSTEP-B.10 (MS1), R17.1, R28.2
unnamed: R112.2, U15.3 (LED2)
unnamed: R111.2, U15.2 (LED1)
unnamed: R110.2, U15.1 (LED0)
unnamed: U5.2 (B1), U5.3 (Y2)
unnamed: R73.2, RX.A
unnamed: R72.2, TX.A
unnamed: C25.2, U3.1 (XTAL1), Y1.1
unnamed: C26.2, U3.2 (XTAL2(PC0)), Y1.2
unnamed: R110.1, R113.2, U19.1 (1A)
unnamed: R103.1, U8.4 (SDA), X-POT.TP
unnamed: R104.1, U9.4 (SDA), Y-POT.TP
unnamed: R105.1, U10.4 (SDA), Z-POT.TP
unnamed: A-POT.TP, R106.1, U11.4 (SDA)
unnamed: B-POT.TP, R107.1, U12.4 (SDA)
unnamed: R109.1, U7.1 (A)
unnamed: R108.1, U6.1 (A)
unnamed: U17.1 (G), U19.5 (2Y)
unnamed: U16.1 (G), U19.7 (1Y)
unnamed: R112.1, R115.2, U19.6 (3A)
unnamed: RGB-LED.4, U18.3 (D)
unnamed: RGB-LED.3, U17.3 (D)
unnamed: RGB-LED.2, U16.3 (D)
unnamed: R111.1, R114.2, U19.3 (2A)
unnamed: U18.1 (G), U19.2 (3Y)
unnamed: EX1.2, FET1.C, Q1.MB (D)
POTS-SCL: POTS-SCL.TP, U4.68 (PJ5(PCINT14)), U8.3 (SCL), U9.3 (SCL), U10.3 (SCL), U11.3 (SCL), U12.3 (SCL)
RD+: R66.1, U3.29 (D+)
RD-: R69.1, U3.30 (D-)
RX-LED: RX.C, U3.10 ((INT5/AIN3)PD4)
SCL: I2C.4, R78.1, U4.43 ((SCL/INT0)PD0), U15.6 (SCL)
SD-CD: INTERFACE.16, U4.18 (PH6(OC2B))
SD-CS: INTERFACE.17, U4.19 ((SS/PCINT0)PB0)
SD-WP: INTERFACE.15, U4.17 (PH5(OC4C))
SDA: I2C.3, R77.1, U4.44 ((SDA/INT1)PD1), U15.7 (SDA)
TEMP1: C9.2, R53.1, TEMP1.1, U4.84 (PK5(ADC13/PCINT21))
TEMP2: C8.2, R48.1, TEMP2.1, U4.85 (PK4(ADC12/PCINT20))
TX-LED: TX.C, U3.11 ((XCK/AIN4/PCINT12)PD5)
UGND: C17.1, L1.1, R67.1, U3.28 (UGND), UGND.TP, X2.4
USHIELD: L1.2, VR1.1, VR2.1, X2.P$1, X2.P$2
UVCC: C24.2, U3.31 (UVCC), UVCC.TP, X2.1
VUCAP: C17.2, U3.27 (UCAP)
X-AXIS-DIR: BOTSTEP-X.16 (DIR), U4.97 ((ADC0)PF0), X-DIR.TP
X-AXIS-EN: BOTSTEP-X.9 (EN), R39.1, U4.95 ((ADC2)PF2), X-EN.TP
X-AXIS-POT: R103.2, U4.94 ((ADC3)PF3)
X-AXIS-STEP: BOTSTEP-X.15 (STEP), U4.96 ((ADC1)PF1), X-STEP.TP
X-MAX: TP29.TP, U4.36 (PL1(ICP5)), X-MAX.4
X-MIN: TP28.TP, U4.35 (PL0(ICP4)), X-MIN.4
Y-AXIS-DIR: BOTSTEP-Y.16 (DIR), U4.93 ((ADC4/TCK)PF4), Y-DIR.TP
Y-AXIS-EN: BOTSTEP-Y.9 (EN), R40.1, U4.91 ((ADC6/TDO)PF6), Y-EN.TP
Y-AXIS-POT: R104.2, U4.90 ((ADC7/TDI)PF7)
Y-AXIS-STEP: BOTSTEP-Y.15 (STEP), U4.92 ((ADC5/TMS)PF5), Y-STEP.TP
Y-MAX: TP31.TP, U4.38 (PL3(OC5A)), Y-MAX.4
Y-MIN: TP30.TP, U4.37 (PL2(T5)), Y-MIN.4
Z-AXIS-DIR: BOTSTEP-Z.16 (DIR), U4.89 (PK0(ADC8/PCINT16)), Z-DIR.TP
Z-AXIS-EN: BOTSTEP-Z.9 (EN), R41.1, U4.87 (PK2(ADC10/PCINT18)), Z-EN.TP
Z-AXIS-POT: R105.2, U4.86 (PK3(ADC11/PCINT19))
Z-AXIS-STEP: BOTSTEP-Z.15 (STEP), U4.88 (PK1(ADC9/PCINT17)), Z-STEP.TP
Z-MAX: TP33.TP, U4.42 (PL7), Z-MAX.4
Z-MIN: TP32.TP, U4.41 (PL6), Z-MIN.4

Notes on the sheet:
External Power Input
X Stepper
MakerBot MightyBoard (REVE)
http://www.makerbot.com/docs/mightyboard
Jeremy Blum / Makerbot.com
Based on the Arduino MEGA by the Arduino Team & MakerBot Gen3 Electronics by Zach "Hoeken" Smith
Limit Switches, E Stop, HBP Temp Input
INTERFACE
ARDUINO MEGA1280/2560 REFERENCE CONTROLLER + 8U2 INTERFACE
EXTRUDER 2 FETS
EXTRUDER 1 FETS
INDICATORS, HACKING, AND PRETTY THINGS
THERMOCOUPLE
I2C
GND Pins
STEPPER MOTORS
UGND > GND
AGND > GND
Remove Cap to Disable Auto-Reset
HBP FET
RGB LED DRIVER
SAFETY CUTOFF
defaults to cutoff state
lights red on cutoff
Test I/O:
Output from MCU - Simulate Failure Condition
Input to MCU - Identify Failure
Reset I/O:
Output from MCU - Used to Re-enable Heaters
EX1&2 Power Checks:
Cross check against test value with MCU to confirm cutoff operation
Y Stepper
Z Stepper
A Stepper
B Stepper
UART 1
FAN1
this is a common anode strip!
USB LEDs
SR NOR LATCH
NOTE: NOT Compatible with Gen4 HBP Therm Connector!!!
FAN2

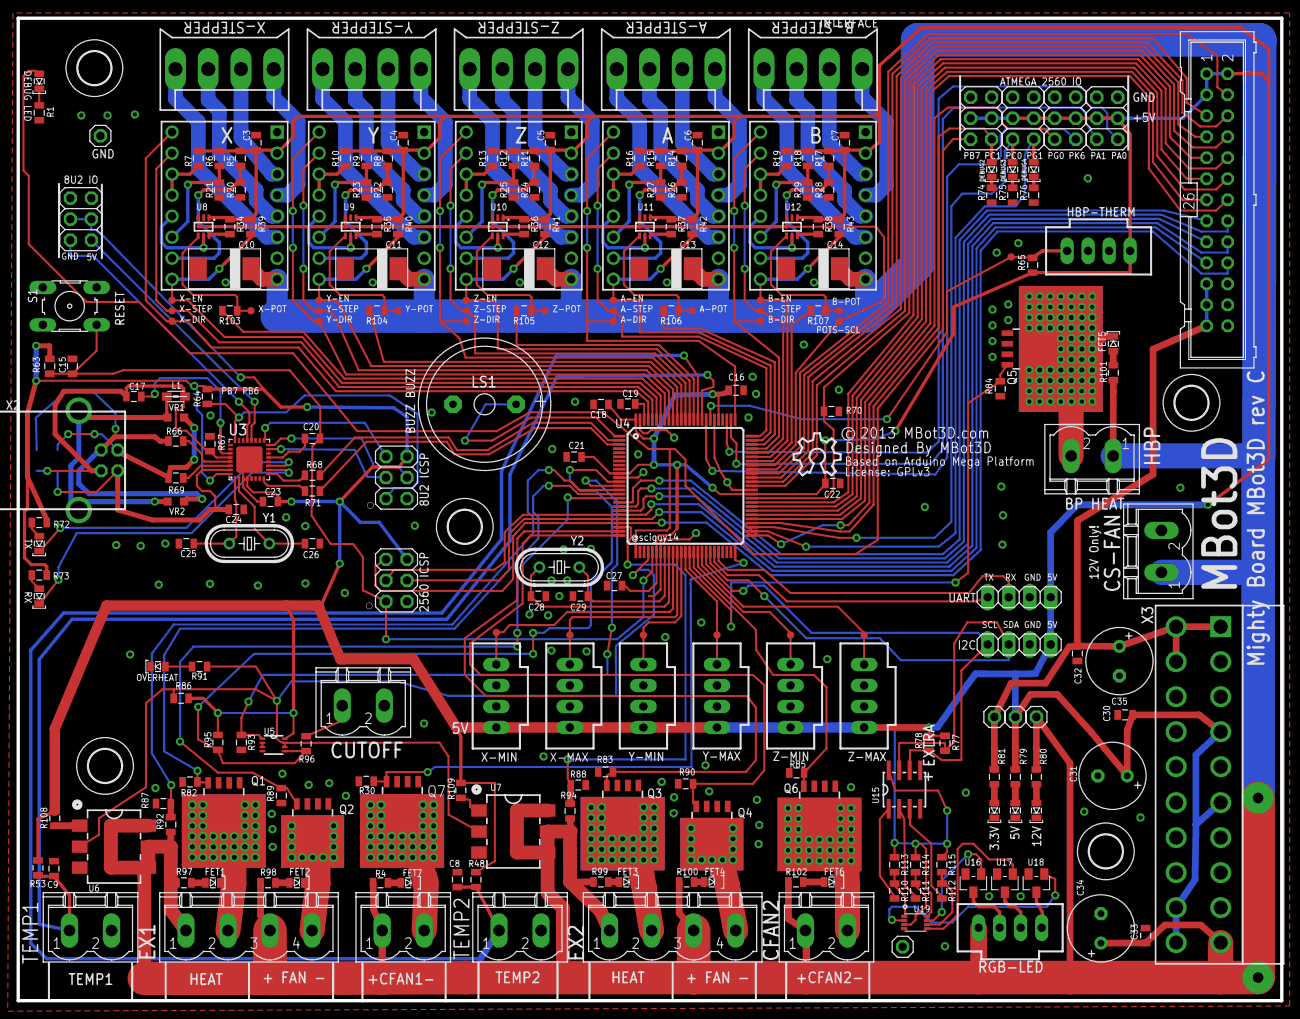
[picture p6: board MBot.brd from above]

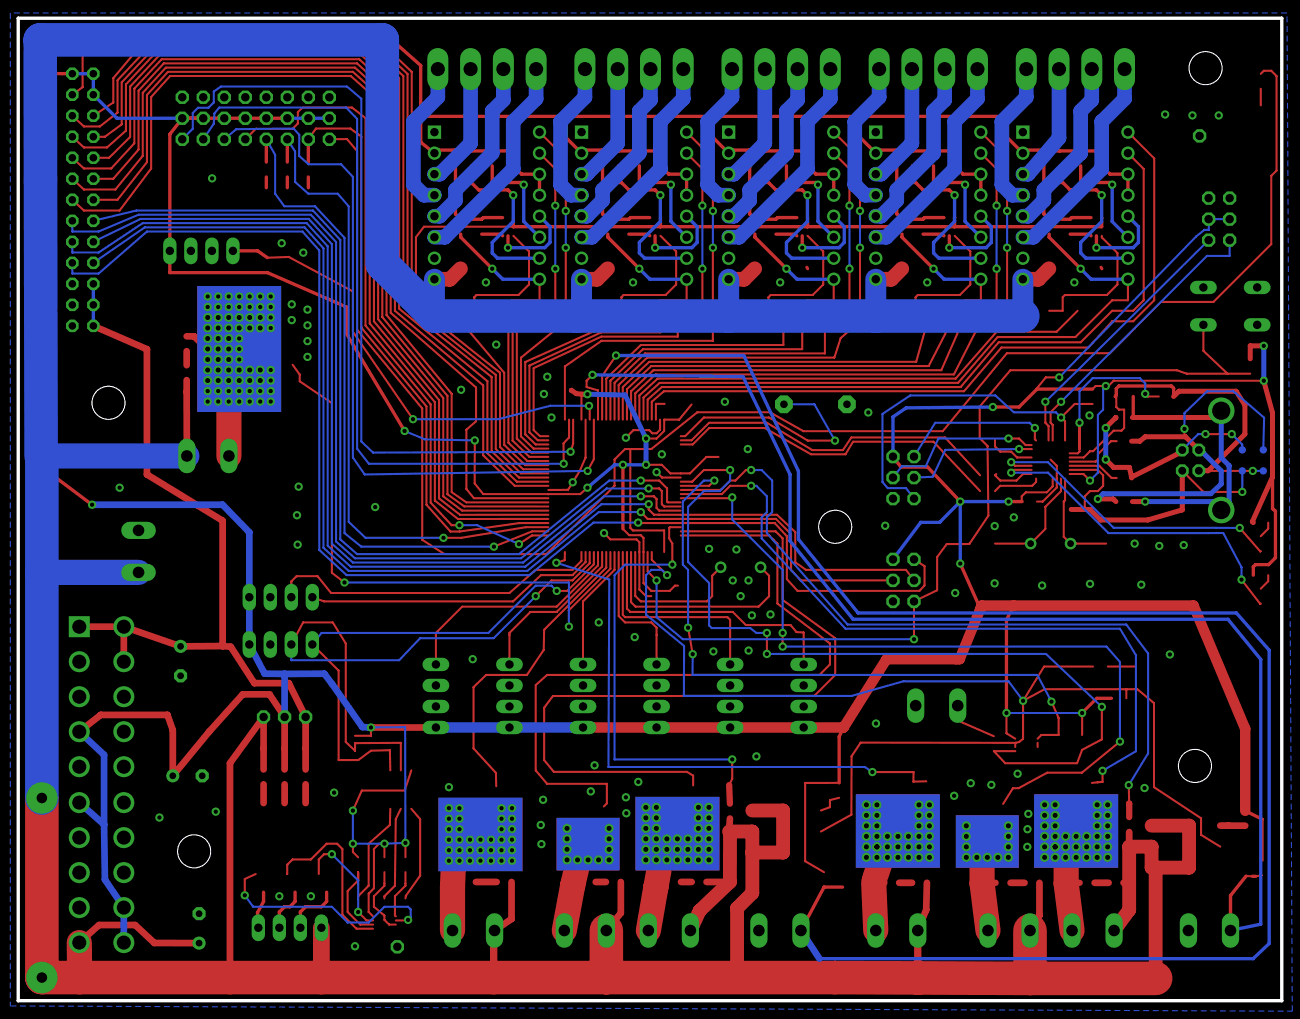
[picture p7: board MBot.brd from below]

Board: 2 copper layers, 152.7 x 118.7 mm, 257 parts (4 on the bottom side), 193 nets.

Other parts of the board:
$$$$$$U$1: 4,0HOLE-3,0KEEPOUT
$$U$1, $$U$7, $$U$8: 4,0HOLE-3,0KEEPOUT
U$1: 4,0HOLE-3,0KEEPOUT
