MBot3D/MBot_3D_Printer_Board/MINI/INTERFACE.brd

## EAGLE design MINI/INTERFACE.brd (2015-03-09)

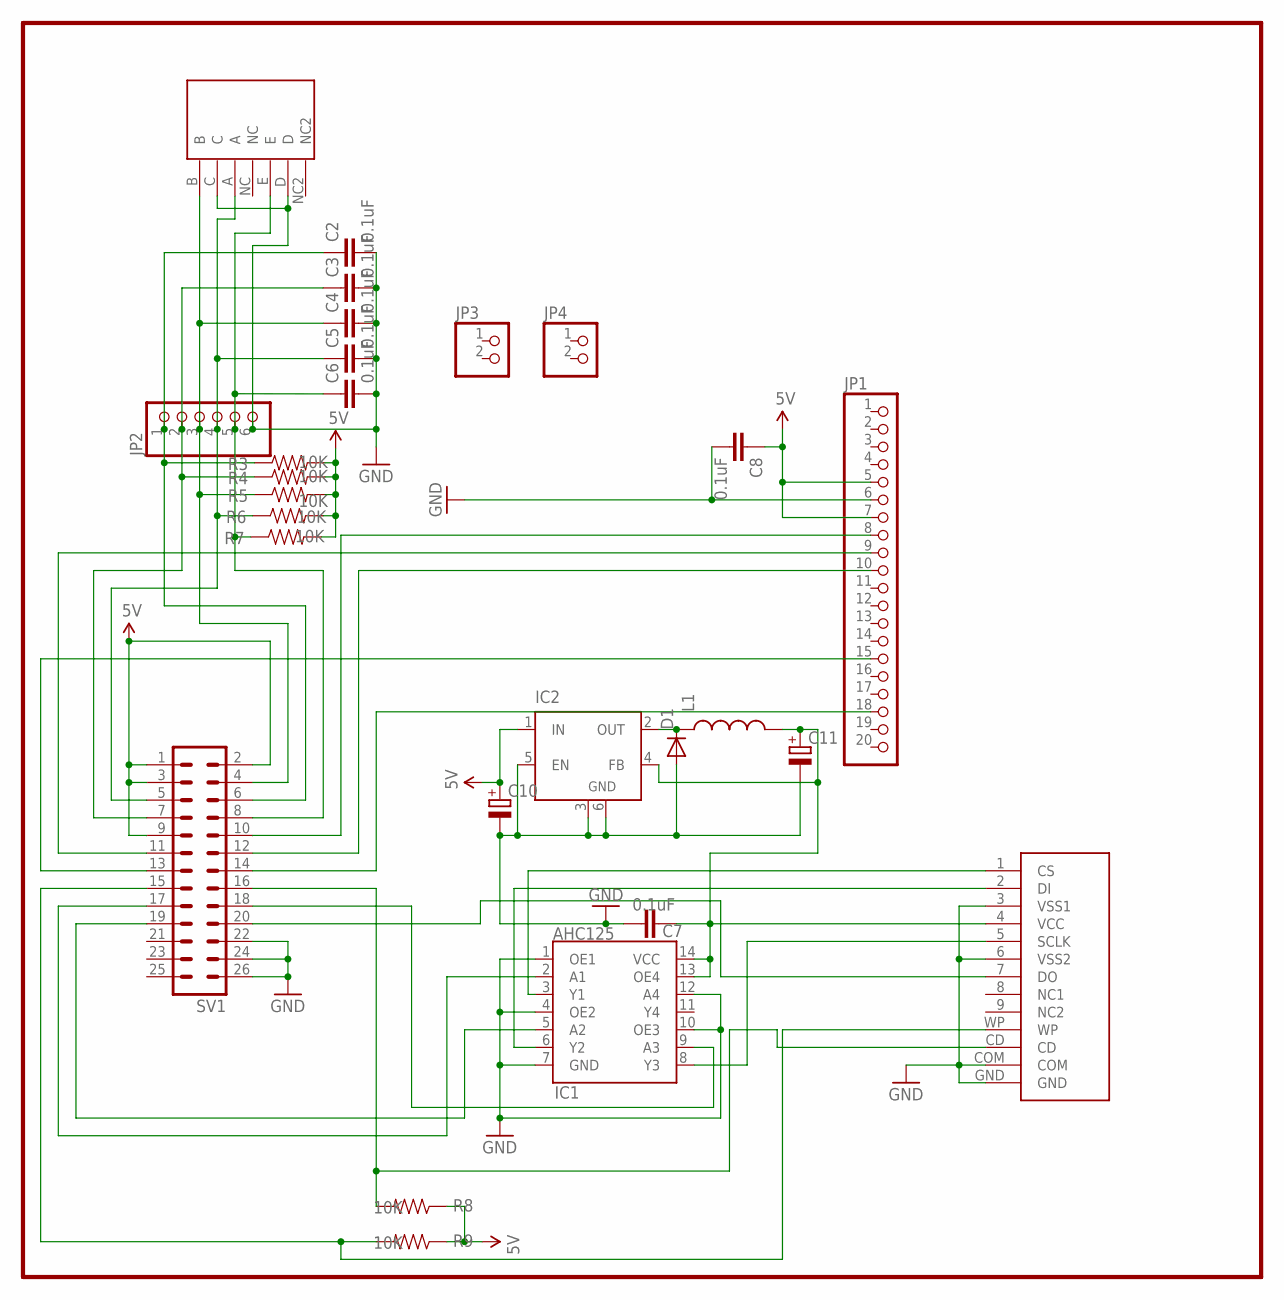
[picture p8: schematic INTERFACE.sch]

Parts:
C2, C3, C4, C5, C6, C7, C8: 0.1uF; 0805
C10, C11: CPOL-EUE3.5-8; E3,5-8
D1: DIODESMB; SMB-DIODE
IC1: AHC125; DIN14
IC2: LM2596S; TO263-5
JP1: PINHD-1X20; 1X20
JP2: PINHD-1X6; 1X06
JP3, JP4: PINHD-1X2; 1X02
L1: INDUCTORPWR; CDRH125
Q2: SDCARD
R3, R4, R5, R6, R7, R8, R9: 10K; 0805
S2: DJFS; PIN5
SV1: ML26

Connections:
5V: C8.1, C10.+, IC2.1 (IN), JP1.5, JP1.7, R3.2, R4.2, R5.2, R6.2, R7.2, R8.1, R9.1, SV1.1, SV1.2, SV1.3, SV1.9
GND2: C2.2, C3.2, C4.2, C5.2, C6.2, C7.2, C8.2, C10.-, C11.-, D1.A, IC1.1 (OE1), IC1.4 (OE2), IC1.7 (GND), IC1.10 (OE3), IC1.12 (A4), IC2.3 (GND), IC2.5 (EN), IC2.6 (GND), JP1.6, JP2.6, Q2.3 (VSS1), Q2.6 (VSS2), Q2.COM, Q2.GND, S2.C, S2.D, SV1.22, SV1.24, SV1.26
unnamed: D1.C, IC2.2 (OUT), L1.1
unnamed: IC1.3 (Y1), Q2.1 (CS)
unnamed: C2.1, JP2.1, R3.1, SV1.6
unnamed: IC1.2 (A1), SV1.17
unnamed: IC1.6 (Y2), Q2.2 (DI)
unnamed: Q2.CD, R8.2, SV1.16
unnamed: Q2.7 (DO), SV1.20
unnamed: JP1.15, SV1.13
unnamed: JP1.8, SV1.10
unnamed: JP1.10, SV1.12
unnamed: JP1.9, SV1.11
unnamed: JP1.18, SV1.14
unnamed: IC1.8 (Y3), Q2.5 (SCLK)
unnamed: C3.1, JP2.2, R4.1, SV1.7
unnamed: C4.1, JP2.3, R5.1, S2.B, SV1.4
unnamed: C5.1, JP2.4, R6.1, S2.A, SV1.5
unnamed: C6.1, JP2.5, R7.1, S2.E, SV1.8
unnamed: Q2.WP, R9.2, SV1.15
unnamed: IC1.5 (A2), SV1.19
unnamed: C7.1, C11.+, IC1.13 (OE4), IC1.14 (VCC), IC2.4 (FB), L1.2, Q2.4 (VCC)
unnamed: IC1.9 (A3), SV1.18

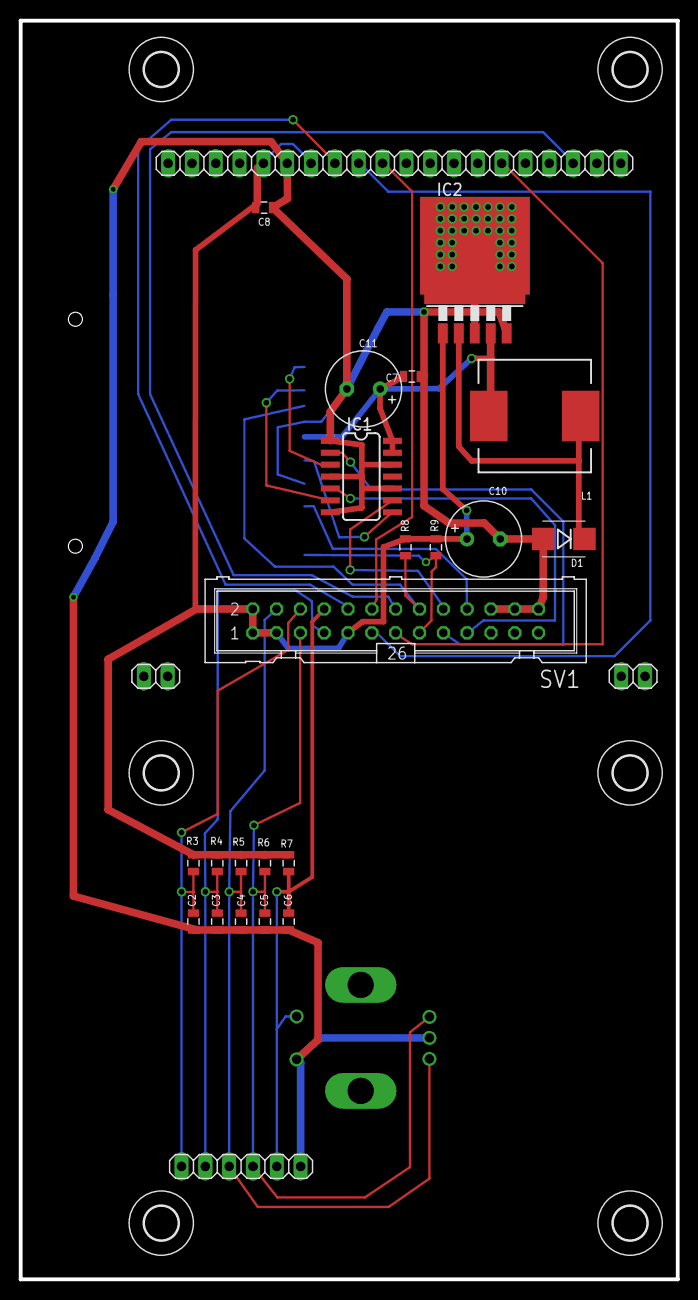
[picture p9: board MINI/INTERFACE.brd from above]

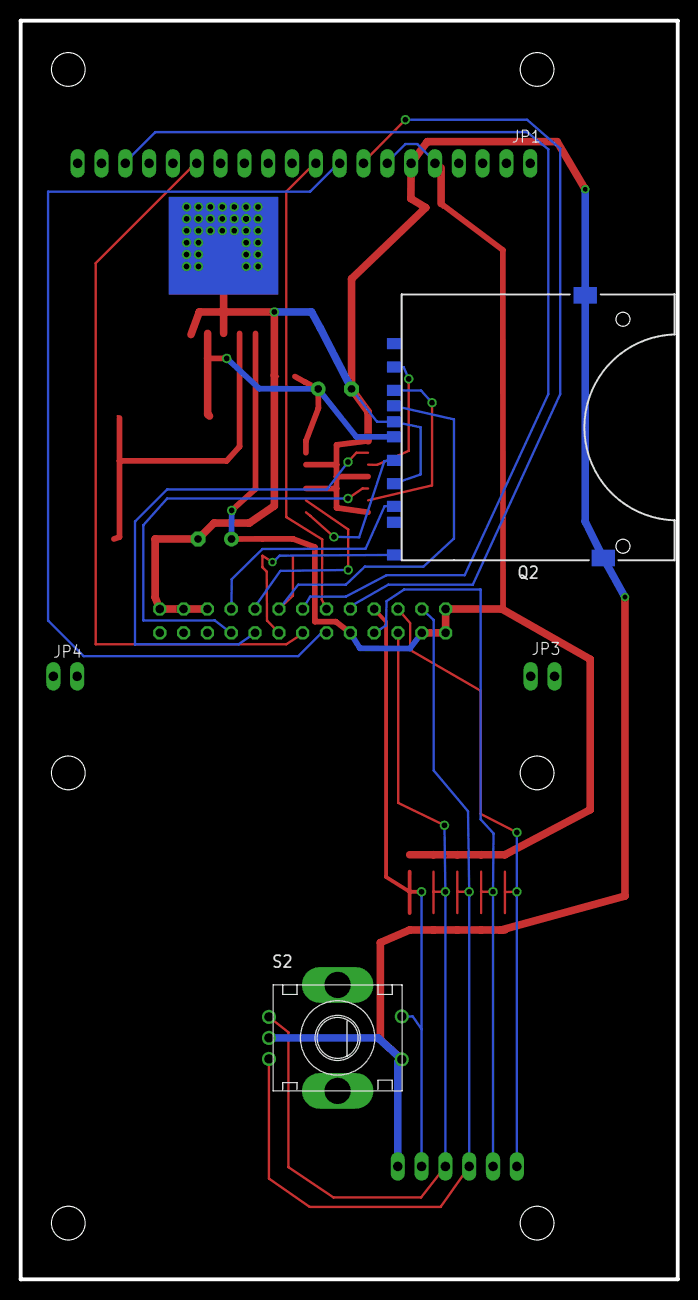
[picture p10: board MINI/INTERFACE.brd from below]

Board: 2 copper layers, 70.1 x 134.2 mm, 33 parts (2 on the bottom side), 23 nets.

Other parts of the board:
U$7, U$9, U$14, U$15, U$16, U$17: 3,6
