MBot3D/MBot_3D_Printer_Board/(notices)

Notices in the files:
GRID2+/MBot.brd:
License: GPLv3
parts and their libraries:
SparkFun2: Licensing: CC v3.0 Share-Alike You are welcome to use this library for commercial purposes.
